praveensehgal/podcast-jukebox/docs/decisions/003-ota-via-github-releases.md

# 003 - Firmware and channel list delivered from GitHub Releases

**Date:** 2026-10-10
**Status:** accepted. Open item resolved 2026-10-10: Praveen made the repo public.
**Context:** Praveen wants to update the firmware remotely and edit the podcast list in git; the device must check for updates on boot.
**Decision:** A version tag `vX.Y.Z` triggers CI to build `firmware.bin`, write `manifest.json` (version, url, sha256, size) and attach both to a GitHub Release. The device fetches `releases/latest/download/manifest.json` on every boot, compares semver with its compiled-in `FW_VERSION`, streams a newer image straight into the inactive OTA partition while hashing it, verifies the sha256, flips the boot partition and reboots. The channel list is `channels.md` at the repo root; a push to `main` validates every feed and republishes the file on a rolling `channels` pre-release that the device downloads and caches in LittleFS. TLS trust is the ESP-IDF certificate bundle, so GitHub's certificate rotations do not strand devices. No tokens or secrets are compiled in; the manifest and channel URLs can be overridden from NVS.
**Alternatives:** Hosting on EC2 behind sehgalp.com (rejected for v1: CI cannot reach the box since SSH is SSM-only, and it adds a deploy path for no gain). Cloudflare R2 (viable later, needs a secret in CI). Pulling `channels.md` from `raw.githubusercontent.com` (same auth constraint as releases, and no validation step).
**Visibility:** public, decided by Praveen on 2026-10-10 so devices fetch release assets without a token. The firmware contains nothing secret; Wi-Fi credentials and the hotspot key are generated on the device and live in NVS. Fallback if it must go private again: mirror the three files to a public HTTPS host and set the NVS URLs.
**Consequences:** No bootloader rollback on the Arduino core's stock sdkconfig: a bad image that boots but misbehaves needs a new release to fix. Mitigation planned: boot counter + self-test before the next release is accepted.

**Trust model, v0:** the image is not cryptographically signed. Authenticity rests on TLS to GitHub (Mozilla root bundle) and the sha256 in the manifest, which comes over the same TLS channel. Anyone who can push a tag to this repo can ship firmware, which is the intended set of people. Planned hardening before the device leaves the house: sign `firmware.bin` in CI with an ed25519 key held in Bitwarden Secrets Manager, embed the public key, and have `ota.cpp` verify the signature before `esp_ota_set_boot_partition`. The captive portal already excludes WiFiManager's upload page, so the only write path to flash is this updater.
