praveensehgal/podcast-jukebox/enclosure/out/enclosure_d_body.3mf

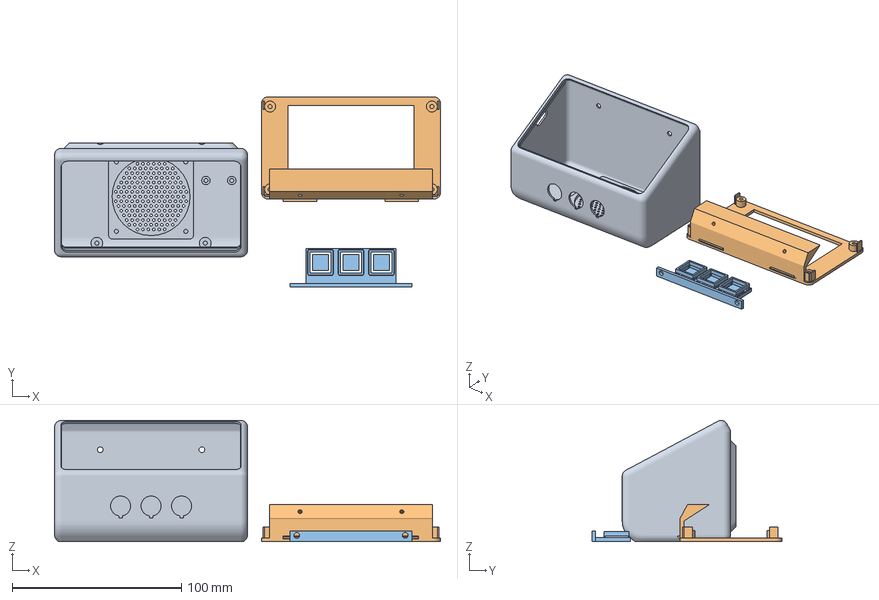
[picture p1: CAD file, 2026-10-11]
enclosure/out/enclosure_d_body.3mf
227.9 x 112.3 x 71.5 mm
face plate
switch bracket
