praveensehgal/podcast-jukebox/enclosure/out/enclosure_d_jig.stl

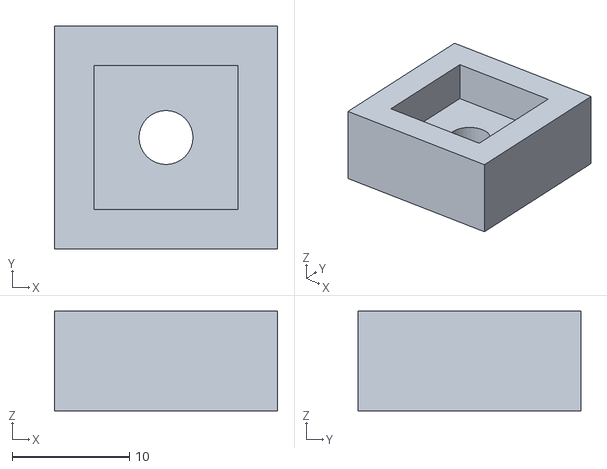
[picture p2: CAD file, 2026-10-11]
enclosure/out/enclosure_d_jig.stl
19.0 x 19.0 x 8.50
