praveensehgal/podcast-jukebox/enclosure/out/enclosure_d_cap_b.stl

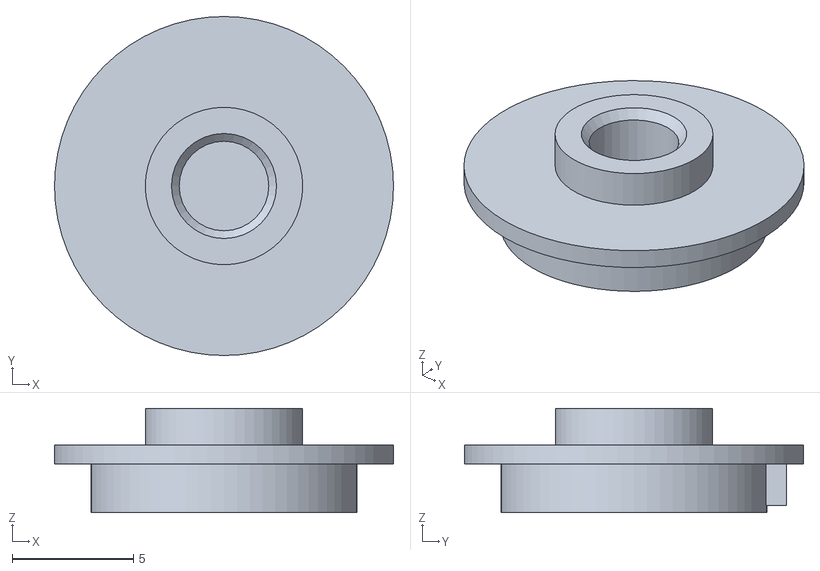
[picture p3: CAD file, 2026-10-11]
enclosure/out/enclosure_d_cap_b.stl
14.0 x 14.0 x 4.30
