praveensehgal/podcast-jukebox/enclosure/out/enclosure_d_bracket.stl

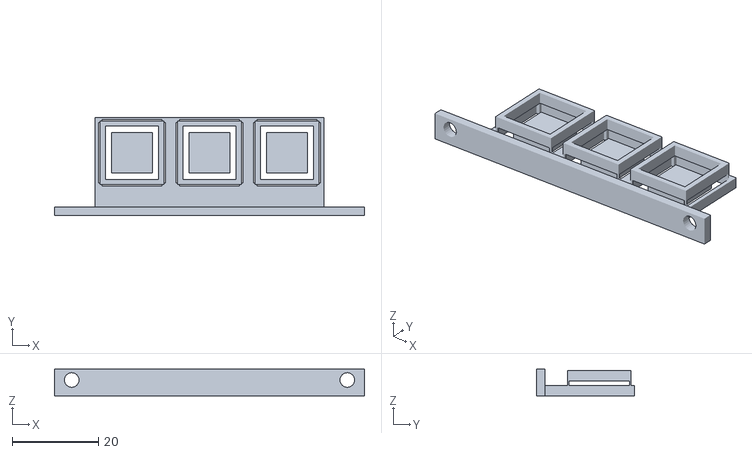
[picture p4: CAD file, 2026-10-11]
enclosure/out/enclosure_d_bracket.stl
72.0 x 22.8 x 6.16
