praveensehgal/podcast-jukebox/enclosure/out/enclosure_d_buttons.3mf

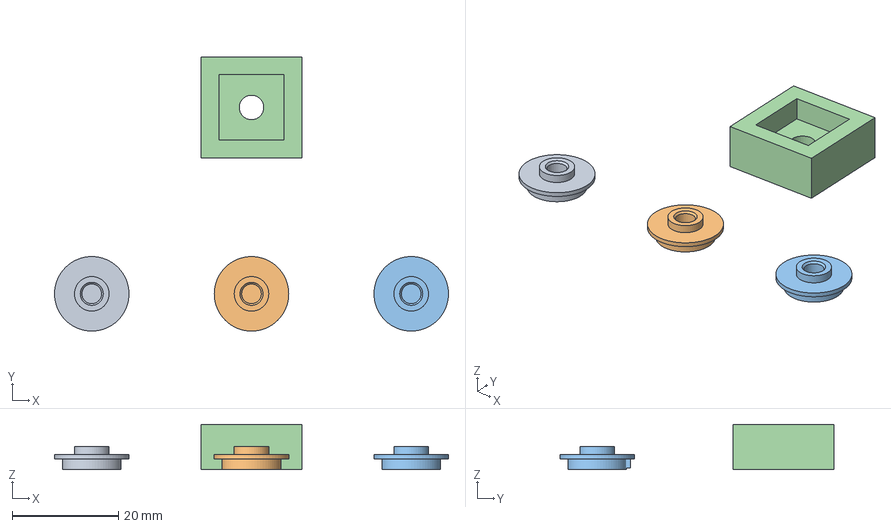
[picture p5: CAD file, 2026-10-11]
enclosure/out/enclosure_d_buttons.3mf
74.0 x 51.5 x 8.50 mm
cap a
cap b
cap c
stem jig
