praveensehgal/podcast-jukebox/enclosure/out/enclosure_d_faceplate.stl

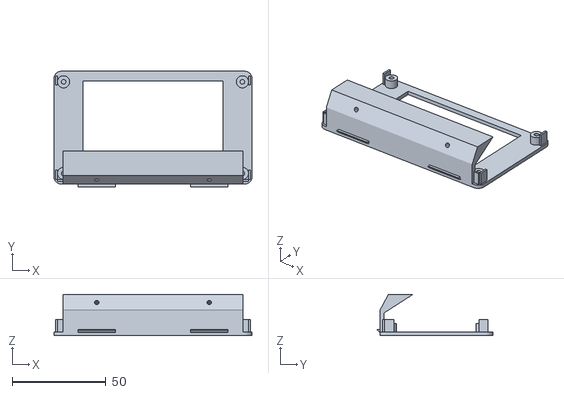
[picture p6: CAD file, 2026-10-11]
enclosure/out/enclosure_d_faceplate.stl
105.7 x 61.8 x 22.0
