praveensehgal/podcast-jukebox/(list of files, cad)

Other CAD files:
enclosure/out/enclosure_d_cap_c.stl
enclosure/out/enclosure_d_cap_a.stl
enclosure/out/enclosure_d_body.stl
