praveensehgal/podcast-jukebox/docs/soldering-guide.html

Podcast Jukebox · bench guide

# Solder the amp, the speaker and the three buttons

Two separate jobs. Job A gives the jukebox its sound. Job B adds the PLAY, PAUSE and STOP switches and can wait for another day. Everything is already on your bench; there is nothing to buy.

350 °Ciron setting, 660 °F, for every joint here

2 secondsiron on a joint. Never more than 4

Job A · 10 jointsabout 30 minutes, one of them small

Job B · 9 jointsabout 40 minutes, three of them small

Before you heat the iron

## Set up the bench

### Station

- Hakko FX-888DX at 350 °C, the T18-D32 chisel tip. Wipe it in the brass wool and melt a little solder on it so it shines.
- Fume extractor on, safety glasses on.
- ESD mat down, wrist strap on whenever you touch the Sunton board.
- Magnifier lamp over the work. Board held in the PanaVise or the helping hands, never in your fingers.
- Fluke 115 within reach.

Unplug the Sunton from USB and leave it unplugged until a step says to plug it in.

### Parts, all owned

MAX98357A amp | A bare one from the four-pack. Its bag has a 2-pin screw terminal (use it) and a 7-pin header strip (leave it out)
Speaker | One 2-inch, 4 Ω, 3 W from the six-pack
Two 4-pin pigtails | 1.25 mm plugs with loose wires, from the Sunton box
22 AWG silicone wire | Red and black, for the speaker
Four thin wires | Cut from Dupont jumpers: one blue, plus three colours you can tell apart for Job B
Three tact switches | The 12 × 12 mm four-leg ones, Job B
Also | 63/37 solder, flux pen, flush cutters, stripper, tweezers, solder wick, heat-shrink, a little tape

The only skill you need

## One good joint

Every joint in this guide is the same four moves. First tin each wire: strip 4 mm, twist the strands, dab flux, then touch iron and solder to it until the strands turn silver.

Side view. Green is the board, copper is the pad, the grey post is the wire, orange is the iron. Feed the solder onto the joint, never onto the tip.

GoodShiny, shaped like a small tent, wire outline still visible.

ColdDull grey ball sitting on the pad. Add flux and reheat.

StarvedBare copper showing. Reheat and feed a little more.

BridgeSolder touching a neighbour. Flux, then lift it off with the wick.

Reference

## Every connection in one place

Schematic, not to scale. The top half is Job A, the three switches are Job B. Follow the labels on your board and the meter checks below, not the positions drawn here.

Wire | From, on the Sunton | To | Job
red | P1 pin 1, VIN 5 V | amp Vin | A
black | P1 pin 4, GND | amp GND | A
yellow | P3 pin 3, IO22 | amp BCLK | A
green | P3 pin 4, IO21 | amp LRC | A
blue, thin | module pad IO16, 12th from the antenna | amp DIN | A
22 AWG | speaker lugs | amp screw terminal, + and − | A
thin | module pad IO18, 9th | PLAY switch | B
thin | module pad IO19, 8th | PAUSE switch | B
thin | module pad IO23, 2nd | STOP switch | B
black | P3 pin 1, GND | one leg of all three switches, in a chain | B

Left unconnected on purpose: amp SD and GAIN; P1 pins 2 and 3 (serial); P3 pin 2 (IO35, kept for the Bluetooth module). Pigtail colours vary between batches, so go by pin position, not by the colours in this table.

Job A · sound

## Wires and amp

No breadboard, and nothing needs holding. For this job the speaker lies on the mat with the cone facing up, and the amp hangs from its four wires. A bare speaker sounds thin and quiet. That is normal: it needs the enclosure behind it.

1. A1

### Find 5 V and ground with the meter

  Plug one pigtail into P1 and one into P3. The plugs are keyed. Strip 4 mm from all eight wire ends and tin them.
  Pin 1 is the end marked on the board's silkscreen. The meter settles any doubt.
  - Spread all eight wire ends apart on the mat so none can touch another. Tape them down.
  - Plug in USB. Fluke on DC volts. Red probe on the wire you think is pin 1, black probe on the wire you think is pin 4.
  - About +5 V means you have them right. About −5 V means they are the other way round. Mark the 5 V wire with red tape and the ground wire with black.
  - Unplug USB.
  - Fluke on continuity. Find the P3 wire that beeps against your P1 ground wire. That is P3 pin 1. Counting from it: pin 3 is IO22, pin 4 is IO21.

done

2. A2

### Solder the screw terminal to the amp

  Push the 2-pin terminal block into the two large holes marked + and −, wire openings facing off the edge of the board. Turn the board over, hold the block flat with tape, solder both legs. These are big joints: three seconds each is fine.
  done
3. A3

### Solder four wires into the amp

  Read the labels printed on your board. If the order differs from this drawing, the labels win.
  - Cut the red, black, yellow and green pigtail wires to about 12 cm.
  - Push each tinned end down through its hole from the chip side: red → Vin, black → GND, yellow → BCLK, green → LRC.
  - Bend each wire over slightly underneath so it stays put, solder on the underside, then snip the excess flush.
  - Vin and GND are neighbours. Look at that pair under the lamp for a bridge.

done

Job A · sound

## Speaker

1. A4

### Solder two wires to the speaker lugs

  - Cut 12 cm of red and 12 cm of black 22 AWG. Strip 4 mm at one end of each and tin it. Strip 5 mm at the other end and leave it bare.
  - Put a small bump of solder on each speaker lug.
  - Lay the tinned wire end on the bump, touch the iron, let it sink in, lift. Red on the lug marked +.
  - Two seconds per lug. The hair-thin braid that feeds the cone is soldered to the same lug and lets go if you linger.
  - Twist the bare ends, push them into the amp's screw terminal, red in +, and tighten. Tug each one.

done

Job A · sound

## The one board joint

The audio data line has no socket pin, so the blue wire goes straight onto the ESP32 module. The module is the metal can on the back of the board. Along its long edges sit rows of small gold pads, 1.27 mm apart. You need one of them.

Pad order from the ESP32-WROOM-32 datasheet, antenna end at the top. Drawn from the datasheet, not from a photo of your board: the beeps in step A5 are what make it certain.

1. A5

### Find pad 12 and prove it

  Fluke on continuity. Count pads from the antenna end.
  - Pad 1 beeps against the metal USB socket shell. So does pad 1 on the other side, so this alone does not pick the side.
  - Pad 3 beeps against your yellow wire (IO22). On the wrong side it stays silent. This picks the side.
  - Pad 6 beeps against your green wire (IO21). Now the count is confirmed twice.
  - Count on to pad 12. Mark the can beside it with a marker dot.

done

2. A6

### Solder the blue wire to pad 12

  - Cut a blue Dupont jumper to a bare wire about 12 cm long. Strip 2 mm, twist, tin.
  - Flux on pad 12. Touch the corner of the tip to the pad with a trace of solder for one second. It leaves a tiny bump.
  - Hold the wire with tweezers, lying flat and pointing away from the module. Rest its tinned end on the bump, touch the iron for one second, lift, hold still.
  - The solder must not reach the can or the pads either side. Tape the wire to the board 1 cm from the joint so nothing can lever it off.
  - Push the other end into the amp's DIN hole and solder it like the rest.

done

Job A · sound

## Check, then power

1. A7

### Six beeps before any power

  USB still unplugged, Fluke on continuity. Only a wrong answer on the first row can damage anything.

Probe | Probe | Expect | If wrong
amp Vin | amp GND | silent | A bridge between the two end pads. Wick it off. A half-second chirp is normal.
amp GND | USB socket shell | beep | Black wire is on the wrong P1 pin, or a cold joint.
amp DIN | module pad 12 | beep | Reflow whichever end of the blue wire looks dull.
module pad 12 | pads 11 and 13, and the can | silent | Bridge at the module. Flux, wick, redo with less solder.
amp DIN | amp BCLK | silent | Bridge between neighbours on the amp.
amp BCLK | amp LRC | silent | Same.

  Across the two speaker terminals the meter does beep. That is the 4 Ω coil and it is correct.
  done
2. A8

### Plug in and play

  Plug the board back into the Mac Studio, as it has been all day, so I can watch its log. Tap a channel, tap an episode. Sound should start within about three seconds, and the board's green LED flickers while it plays. Try the − and + buttons on the screen.

What you get | What it means
Silence, LED flickering | Data is arriving. Measure 5 V between amp Vin and GND, then check the terminal screws.
Silence, LED dark, time counting up | The blue wire is not on IO16. Recount to pad 12.
Noise or garbled sound | Yellow and green are swapped. Swap them at the amp.
Crackle when you touch a wire | A cold joint. Reflow that wire's two ends with flux.
Screen restarts when it gets loud | The USB port cannot supply the peaks. Turn it down for now and tell me; the finished jukebox runs from a 5 V 3 A adapter.

  Then tell me what you hear. Clean, quiet, distorted or nothing: each one points at a single cause, and level is a firmware change on my side.
  done

Job B · buttons

## Switch harness

Wait for the switch holder before you solder this job. The enclosure does not yet have the part that holds the three switches under the top buttons, and the wire lengths here depend on it. The Pause and Stop buttons on the screen do the same job until then. To try real switches sooner, push them into a breadboard across its centre gap instead of soldering their legs.

Do this after Job A plays. All of the switch soldering happens off the board, on the mat. Unplug the P3 pigtail while you work on its black wire if that is easier.

The microSD slot stays empty from now on. The three button lines are the card slot's own pins, and a card in the slot would fight the buttons.

Legs are joined inside in pairs, and which pairs depends on the maker. Two legs at opposite corners are never a pair, so they always work.

1. B1

### Build the chain

  - Cut three thin signal wires, about 14 cm, in three colours. Flag the free ends with tape: PLAY, PAUSE, STOP.
  - Cut two black links of about 4 cm.
  - On each switch, solder the signal wire to one corner leg. Lay the tinned wire along the leg and heat both.
  - On the opposite corner leg of each switch, solder the ground: the black P3 pin 1 wire to the first switch, then a link on to the second, then a link on to the third. The middle legs take two wires in one joint.
  - Slide heat-shrink over each leg joint and shrink it with the hot barrel of the iron held close, not touching.

done

2. B2

### Beep each switch before it goes near the board

  One probe on the black P3 wire, the other on a signal wire's free end. Silent when released, beep when pressed. Repeat for all three.
  done

Job B · buttons

## Three board joints

1. B3

### Solder the signal wires to pads 9, 8 and 2

  Same module edge and same small joint as step A6. Use the pad map above and count from the antenna end again.

Switch | Pad | Pin | Watch for
PLAY | 9 | IO18 | Pads 8 and 9 are neighbours. Solder pad 9 first, check it, then pad 8.
PAUSE | 8 | IO19 | Pad 7 beside it is unused, so a slip that way is harmless.
STOP | 2 | IO23 | Pad 1 beside it is ground. A bridge there is a STOP button held down for ever.

  Keep away from pads 4 and 5. They are the serial lines I use to flash and talk to the board.
  Lead each wire straight off the module edge and tape all three down together 1 cm out.
  done

Job B · buttons

## Check and test

1. B4

### Beeps, USB unplugged

Probe | Probe | Expect
pad 9, pad 8, pad 2 in turn | USB socket shell | silent released, beep with that switch pressed
pad 9 | pad 8 | silent
pad 2 | pad 3 | silent

  done
2. B5

### Plug in and press

  Start an episode from the screen, then:

Press | The jukebox should
PAUSE | Go quiet; the pause button on the screen turns amber. Press again to resume.
STOP | Stop and return to the channel list.
PLAY | Pick the same episode up where it stopped.
STOP, held three seconds | Open Settings.

  If Settings opens by itself or the list keeps returning to Channels, the STOP line is shorted to ground: look at pads 1 and 2. If PLAY and PAUSE act together, pads 8 and 9 are bridged.
  done
