praveensehgal/podcast-jukebox/(commit log)

2026-10-10 feat: firmware skeleton with boot-time OTA, channel list from channels.md, CI release pipeline
    Podcast Jukebox: a 2-knob, 3-button podcast player for a 60-year-old TV watcher.
    This first commit is the update plumbing, so every device shipped can be fixed
    remotely, plus the frozen design.
    - src/ota.cpp: on boot fetch releases/latest/download/manifest.json, semver compare,
    stream a newer firmware.bin into the inactive OTA slot while hashing, verify sha256,
    switch boot partition, reboot. TLS via the ESP-IDF cert bundle; no secrets in firmware.
    - src/channels.cpp: fetch channels.md (markdown table in this repo, published on the
    rolling 'channels' release), parse rows, cache in LittleFS fo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
    [channels.cpp, channels.h, main.cpp, ota.cpp, ota.h, version.h]
2026-10-10 fix: remove firmware-upload page from the setup portal; document OTA trust model
    WiFiManager's default menu exposes an unauthenticated /update page on the open
    Jukebox-Setup hotspot. Restrict the portal to wifi/info/exit so the release updater
    is the only write path to flash. Decision 003 now states the v0 trust model and the
    planned ed25519 image signing.
    Claude-Session: https://claude.ai/code/session_01RkSgfKGJHB1ikRrtRJ3c5G
    [main.cpp]
2026-10-10 fix: WPA2 on the setup hotspot with a per-device key
    WiFiManager registers /update and /u unconditionally, so removing the menu entry
    did not close the upload path. The Jukebox-Setup hotspot now requires a key derived
    from the device MAC (jb-xxxxxx), printed on serial and later carried in the Wi-Fi
    screen's QR code so the installer never types it.
    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
    [main.cpp]
2026-10-10 fix: random per-device setup-hotspot key in NVS instead of MAC-derived
    The AP beacons its MAC, so a key derived from it was readable off the air. The key
    is now 12 characters from the hardware RNG, generated on first boot and stored in
    NVS. Still printed on serial and destined for the Wi-Fi screen's QR code.
    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
    [main.cpp]
2026-10-10 feat: backlight on at boot; flash.sh refuses non-ESP32 chips
    Backlight (GPIO 27) goes high first thing in setup so a freshly flashed Sunton is
    visibly alive before any UI exists. flash.sh now reads the chip id and refuses
    anything that is not a plain ESP32: the first bench attempt autodetected the
    CrowPanel notetaker (ESP32-P4) on the only CH34x port because the Sunton was not
    enumerating. esptool caught it; now the script does too, before pio runs.
    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
2026-10-10 fix(http): follow redirects in streaming mode and size the TX buffer for GitHub asset URLs
    First boot on the Sunton showed both fetches stopping at HTTP 302. esp_http_client
    only auto-follows redirects inside esp_http_client_perform(); the streaming
    open/fetch_headers/read path we use for hashing leaves it to the caller. New
    http_get module loops open -> fetch_headers -> set_redirection up to 5 hops.
    Second finding: GitHub's signed asset URLs are ~800 chars and the default 512-byte
    TX buffer fails with 'Out of buffer', so buffer_size_tx is 2048.
    Verified on hardware with a 9.9.9 test build: manifest parsed through two hops,
    channels.md loaded with 20 rows. flash.sh chip guard now uses the e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
    [channels.cpp, http_get.cpp, http_get.h, ota.cpp]
2026-10-10 feat(ui): display bring-up, LVGL 9, boot status screen, channel list, serial stand-in controls
    Stage A of the screen build. LovyanGFX drives the ST7796 (pin map and invert=false
    from the macro-pad project on the same board); LVGL 9.6 with a trimmed lv_conf and
    a 40-line partial draw buffer in DRAM. Boot screen shows version and plain-English
    status while Wi-Fi, update check and channel load run, including the hotspot name
    and key when the portal opens. Channel list is a virtual 8-row list with whole-row
    highlight, art tiles and scrollbar, fed by channels.md. Input is an event stream;
    until the encoder, pot and buttons are wired, serial keys stand in (j/k/o/p/s/S/+/-).
    Dev builds now report b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
    [display.cpp, display.h]
2026-10-10 feat(audio): HTTPS MP3 streaming through ESP8266Audio Helix decoder; persistent I2S
    The go/no-go spike for this no-PSRAM board. ESP32-audioI2S links every codec
    (870 KB, 128% of the OTA slot) and has no way to drop them, so it is out.
    ESP8266Audio links only the decoder you instantiate: Helix MP3 costs ~50 KB.
    AudioSourceHttps feeds it through http_get (cert bundle, redirects, byte-range
    resume). PersistentI2S opens the I2S channel once at boot: the stock output
    allocates DMA descriptors inside begin() at play time, which failed once TLS and
    the ring buffer had fragmented the heap. LVGL software renderer trimmed to RGB565
    and A8 formats, which paid for the decoder.
    Bench, 2026-10-10: NPR Ne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
    [audio_out.cpp, audio_out.h, audio_source.cpp, audio_source.h, http_get.cpp, http_get.h, input.cpp, input.h]
2026-10-10 feat(app): episode list, Now Playing, resolver client, state machine
    Stages C and D. resolver_client fetches compact episode lists from the resolver
    (ArduinoJson filter, positions merged for NEW / n% played / Played badges), saves
    positions on pause, stop and every 30 s, and refreshes CDN URLs before play.
    screen_episodes: 4 rows of 71 px with date box, two-line title, badge, duration and
    progress bar. screen_playing: art tile, title, elapsed / total, PLAYING / PAUSED
    pill, progress bar, refreshed once a second. app.cpp owns the Channels -> Episodes
    -> Playing machine from decision 001: STOP is back from anywhere, PAUSE toggles from
    anywhere, OK on Now Playing returns to the list with audio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
    [app.cpp, app.h, audio_out.cpp, channels.cpp, http_get.cpp, main.cpp, ota.cpp, resolver_client.cpp]
2026-10-10 feat(ui): Settings, Wi-Fi scan + QR, knob password entry, Bluetooth screen, sleep timer
    Stage E, the rest of the mockup. Settings is reached by holding STOP or from the
    row past the last channel. Wi-Fi lists scanned networks with strength and a QR
    code for the Jukebox-Setup hotspot (WPA2, device key); OK on a network opens the
    character strip (abc/ABC/123/symbols via PAUSE, DEL and DONE tiles), DONE joins
    and persists credentials. Bluetooth screen drives a KCX_BT_EMITTER over Serial2
    (RX 35, TX 17) through a loose AT parser that logs everything; without the module
    it shows 'not fitted'. Sound output and sleep timer live in NVS (settings.cpp).
    app.cpp rewritten: the playing episode is now a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
    [app.cpp, app.h, bt_emitter.cpp, bt_emitter.h, main.cpp, settings.cpp]
2026-10-10 docs: handoff stage table, pin map, bench state after the screen build
    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
2026-10-10 feat(resolver): FastAPI service: channels, episode lists, positions, URL resolve; SSRF guard and body caps
    Built by a subagent to the spec in the firmware's resolver_client. Python 3.12,
    FastAPI + uvicorn, SQLite (WAL), httpx, defusedxml RSS/Atom parsing. Endpoints:
    /health, /channels (channels.md from the GitHub release, 10 min cache, last-good
    copy on failure), /episodes (15 min cache, final audio URLs resolved through the
    podtrac/chartable redirect chains with 8 concurrent probes), /position GET+POST,
    /positions, /resolve. Optional X-Jukebox-Token on everything but /health.
    Outbound policy after review: http(s) only, ports 80/443, every host resolved and
    every address must be public (loo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
2026-10-10 fix(resolver): pin connections to the vetted IP, negative cache, capped streaming, service-wide probe budget
    Second review round. guard.py wraps the httpx transport so every connection,
    including redirect hops, resolves the host once, requires public addresses, dials
    the literal IP with the original Host header and SNI, closing the DNS-rebinding
    window. episodes.py gets a 60 s negative cache and per-feed single-flight so an
    unreachable feed costs one upstream fetch per minute, not one per device request,
    with bounded tracking tables and a 35 s refresh budget. fetcher.py reads raw wire
    bytes against the cap before buffering, refuses unexpected encodings and bounds
    inflation, and closes the st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
2026-10-10 fix(resolver): per-request budget with partial resolution, refresh cap, enclosure URL policy
    Third review round. /episodes runs under a 20 s wall-clock budget covering lock
    wait, fetch and on-demand probes; probes still pending at the deadline are
    cancelled and those episodes return their enclosure URL, retried next time.
    Upstream feed fetches are capped at 4 in flight service-wide; a request that
    times out while queued is not negative-cached. Enclosure URLs are checked at
    parse time (http/https, host, port 80/443) so hostile feeds cannot plant ftp:,
    file: or odd-port URLs, and every probe already goes through the pinned, public-
    address-only transport, so an intranet or metadata enclosure i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
2026-10-10 fix(resolver): /episodes and /resolve bound to the channel list
    Fourth review round, structural: /episodes accepts only a feed URL that matches a
    row of the current channel list (10 min cache, last-good copy), everything else is
    404 with no fetch, cache, lock or negative-cache side effect; with no list at all
    it fails closed with 502. /resolve accepts only the enclosure or resolved URL of an
    episode cached for an allow-listed feed, loading the feed cache from SQLite after a
    restart. Tracking tables sized to 64 feeds. The input space is now 20 feeds times
    50 episodes, which is what the earlier budgets were trying to approximate.
    119 tests, 97% coverage, ruff clean, smoke test green.
    Claude-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
2026-10-10 docs: illustrated amp and speaker wiring guide
    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
2026-10-10 feat(enclosure): touch-wedge shell concept C, OpenSCAD source and scale mockup
    Wedge 118 x 52 x 70 mm, 49 deg face, 76 x 51 window, 50 mm grille on the vertical
    back, USB slot, 1.2 mm thin-wall prototype open underneath, printed back-face-down
    without supports. Mockup page and SCAD share one set of numbers. STL output is
    generated locally (enclosure/out, ignored).
    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
    [wedge_shell.scad]
2026-10-10 docs(enclosure): concept D mockup: soft wedge, black glass face, top buttons, rear speaker
    Interactive three.js render with four finishes, a section view with the display,
    board, speaker and switches at size, and computed clearance checks (all pass at
    114 x 68 x 67 mm, 62 deg face). Replaces the touch-only wedge after Praveen's
    review: needs play/pause/stop buttons, side USB, room for the speaker, and an
    Apple / B&O look.
    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
2026-10-10 feat(enclosure): concept D prototype print files (shell, black face plate, button caps)
    enclosure/build_d.py builds the approved design with manifold3d in about a second
    (OpenSCAD 2021's CGAL would take minutes on the ~160 grille holes): profile hulls of
    spheres for the rounded body, 1.2 mm shell open underneath, 45-degree floating plinth
    ring, 0.6 mm face recess filled by a separate black plate, window 74.5 x 50 (active
    area + 1 mm), three 11.8 mm button holes on the top, hex-perforated speaker grille
    on the back, USB slot on the right side aligned to the screen angle.
    Printability change agreed in the session: the lip under the screen is angled back
    under the body, so the shell prints fac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
    [enclosure_d_caps.stl, enclosure_d_faceplate.stl, enclosure_d_print.3mf, enclosure_d_shell.stl]
2026-10-10 chore(enclosure): ruff clean (dict literals, unused variable, timezone-aware date)
    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
    [enclosure_d_print.3mf]
2026-10-10 docs(screens): touch redesign mockup, 8 screens at native 480x320 with tap-target overlay
    Touch picks, three top buttons do play/pause/stop. Paged lists with big arrows
    instead of swiping (resistive touch), 10 mm minimum targets, on-screen keyboard
    for Wi-Fi, phone QR route kept.
    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
2026-10-10 fix(security): scrub the bench board's setup-hotspot key from the mockup and rotate it
    The touch-screen mockup used the bench board's real WPA2 setup key as sample text
    and was pushed to the public repo (gitleaks flagged it; my commit chain piped
    gitleaks through tail and lost its exit code). The text is now a placeholder, and
    the firmware drops the old NVS key and generates a new one under a new name on
    the next boot, so the published value is dead. History is not rewritten: a
    rotated key in history is harmless.
    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
    [main.cpp]
2026-10-10 fix(enclosure): one-filament 3MF by default, face-down shell prints without mid-air spans
    The print file put the face plate on filament 2, so the first 0.6 mm of the face needed a nozzle change every layer, and Bambu Studio flagged the shell for floating regions: the bottom wall strip and foot bar across the back hang from the back-bottom corner when the part is face-down, so they started as 100 mm bridges in mid-air, and the face's edge radius stepped 1.5 mm out on layer two.
    Default 3MF is now one fused shell plus the button caps, all on filament 1; the two-colour version is kept as enclosure_d_print_2colour.3mf. Geometry: 45 degree bevel where the face meets the bed, underside open back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
    [enclosure_d_print.3mf, enclosure_d_print_2colour.3mf, enclosure_d_shell.stl, enclosure_d_shell_onecolour.stl]
2026-10-10 chore(enclosure): stop tracking the compiled bambu3mf .pyc
    The previous commit meant to drop it, but a pathspec commit takes the working-tree file, so it went in as modified instead. It is build output and is now covered by enclosure/.gitignore.
2026-10-10 feat(resolver): relay episode audio over plain HTTP at GET /stream
    The ESP32 in the jukebox has no PSRAM. Measured on the bench: about 105 KB of usable heap before a stream opens, 56-75 KB for one TLS session to a podcast CDN, 34 KB for the MP3 decoder, 16 KB for the ring buffer. The sum does not fit, so the device now fetches audio from the resolver and the resolver does the HTTPS, redirects and signed URLs (decision 005).
    /stream serves only URLs of cached episodes of channel-list feeds, tries the resolved URL and then the enclosure, passes a resume Range through, holds at most 4 relays and stops at 1 GiB each. 16 new tests; 135 pass, 96% coverage, ruff clean.
2026-10-10 feat(firmware): touch navigation, three top buttons, audio through the resolver relay
    Touch (decision 004): the XPT2046 is read through LovyanGFX into an LVGL pointer device; taps queue input events that the app handles in loop(). All eight screens from the touch mockup are rebuilt on a shared header, paged list with arrow rail, and row widget: Channels, Episodes, Now Playing (skip 30 s either way, volume), Settings, Wi-Fi list, password keyboard, phone QR setup, Bluetooth. PLAY, PAUSE and STOP are read on GPIO 18/19/23; STOP held 3 s opens Settings.
    Playback (decision 005): tap-to-play aborted with bad_alloc, and the previous commit did the same. TLS plus the MP3 decoder plus the ring buff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
    [app.cpp, app.h, app_internal.h, app_setup.cpp, audio_out.cpp, audio_out.h, display.cpp, display.h]
2026-10-10 fix: close review findings on the relay and the setup portal; guard the MP3 decode loop
    Resolver: a relay's slot and upstream connection are now released from the response call itself, so a client that leaves or never reads cannot leak one of the four slots, and the release survives a failing close. Opening a stream has a 30 s budget across its redirect chain and a relay is cut at 6 hours. Three new tests; 138 pass.
    Firmware: WiFiManager registers its firmware-upload, erase, restart, info and parameter pages on every portal. portal_guard.h answers those paths with 404 from the hook the library calls before it registers its own, on both the boot portal and the phone-setup portal, and the pho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
    [app_setup.cpp, audio_out.cpp, main.cpp, portal_guard.h]
2026-10-10 fix(ui): Pause and Stop on the Now Playing screen; no notice ends on a button press
    Praveen started an episode before the top switches were wired and had no way to stop it: pause and stop existed only as physical buttons. Now Playing's bottom row is now back 30 s, pause/resume, stop, forward 30 s, volume down, volume up, with the volume bars beside the time. The pause button shows what a tap will do and turns amber while paused.
    The two "Lost the stream" notices told the user to press PLAY and offered nothing to tap. They now show for 2.5 s and return to the episode list, where tapping the episode resumes from the same second.
    [app.cpp]
2026-10-10 docs: illustrated soldering guide for the amp, speaker and three switches
    Replaces amp-wiring-guide.html. Two jobs with numbered steps, tick boxes and nine drawings: the four moves of a joint and what good and bad ones look like, every connection in one diagram and one table, socket pinouts with a meter check for 5 V, the amp's pads, the speaker lugs, the ESP32 module's edge pads counted from the antenna, and the tact switch's legs.
    DIN now goes to the module's IO16 edge pad instead of the LED resistor, so Job A and Job B use the same kind of joint and the same pad map. The pad order comes from the datasheet, not a photo of the board; the guide proves it with two continuity checks before an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
2026-10-10 docs: say how parts are held on the bench; record that enclosure D has no internal mounts
    The soldering guide now says Job A needs no breadboard or holder, and that Job B
    should wait for the switch carrier (or use a breadboard for an early test), because
    the harness lengths depend on a part that does not exist yet. HANDOFF lists the
    missing speaker seat, switch carrier, board posts and stem-socket caps, and the
    unchecked clearance between the centre switch and the speaker magnet.
2026-10-10 docs: enclosure mockup with the measured speaker and the internal mounts
    The speaker is 28.2 mm deep (caliper photo), not the 20 mm the shell was drawn
    around, so the body grows from 68 to 73 mm deep. The mockup now draws the real
    speaker shape and proposes how each part is held: raised seat and four screws for
    the speaker, one bracket for the three switches with stems cut to 9 mm, a lift-out
    face plate carrying the Sunton, pegs for the amp, a closed floor. Clearances are
    computed in the page. HANDOFF lists which numbers are measured and which are not.
2026-10-11 feat(enclosure): two-part body with every mount, printed on its back; face plate carries the screen
    The body prints lying on its back wall: speaker seat with four M3 bosses, two
    posts for the switch bracket, amp pegs, closed floor, bevelled back edges. The
    face plate prints face down: four board posts, corner stops, two tongues under
    the skin below the opening, a fin and foot that stand on the floor and take
    two M3 screws from underneath. Switch bracket with pockets and leg slots,
    three keyed caps with stem sockets, and a jig that cuts the stems to 8.5 mm.
    build_d.py refuses to write files unless the assembled parts clear each other,
    the plate swings in without touching, and the floor screws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
    [enclosure_d_body.3mf, enclosure_d_body.stl, enclosure_d_bracket.stl, enclosure_d_buttons.3mf, enclosure_d_cap_a.stl, enclosure_d_cap_b.stl, enclosure_d_cap_c.stl, enclosure_d_caps.stl]
2026-10-29 feat(firmware): resolver on EC2 with an access token; say when the server is unreachable
    - Default resolver is http://jukebox.sehgalp.com (EC2 behind nginx), not the Mac.
    Plain HTTP stays: no TLS session next to the decoder (decision 005).
    - The token lives in NVS (ota/token), set over serial with '#token <value>'; it is
    never compiled in, the repo is public (decision 003). http_get adds
    X-Jukebox-Token only to URLs under the resolver base and drops it on a redirect
    off that prefix, so GitHub never sees it. '#resolver <url>' and '#cfg' too;
    '#cfg' prints the token's length, never its value.
    - A failed episode fetch now says 'Can't reach the podcast server' and returns to
    the chan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
    [app.cpp, http_get.cpp, http_get.h, input.cpp, input.h, main.cpp, resolver_client.cpp, resolver_client.h]
2026-10-29 chore(resolver): the live nginx site for jukebox.sehgalp.com
    Port 80 is plain HTTP with no redirect, for the device; 443 for people and
    tests. /stream is unbuffered with 6 h timeouts. Copied from EC2 after deploy.
    Claude-Session: https://claude.ai/code/session_01D9UdotRBEAMCqXJESFi9Nh
2026-10-29 fix(firmware): token only for the resolver's exact origin, never on a redirect
    Review findings on fcaaf23. wantsAuth matched by bare prefix, so
    http://jukebox.sehgalp.com.evil.com/ and ...com@evil.com/ would have been sent
    the token; the prefix must now end at '/', '?', '#' or the end of the URL
    (checked host-side: 7 cases). savePosition used esp_http_client_perform with
    auto-redirect on, which would carry the header to a 3xx target; redirects are
    now off and a 3xx counts as a failed save.
    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
    [http_get.cpp, resolver_client.cpp]
